szdiy/blackberry_q10_keyboard_pcb/Q10_keyboard.pdf

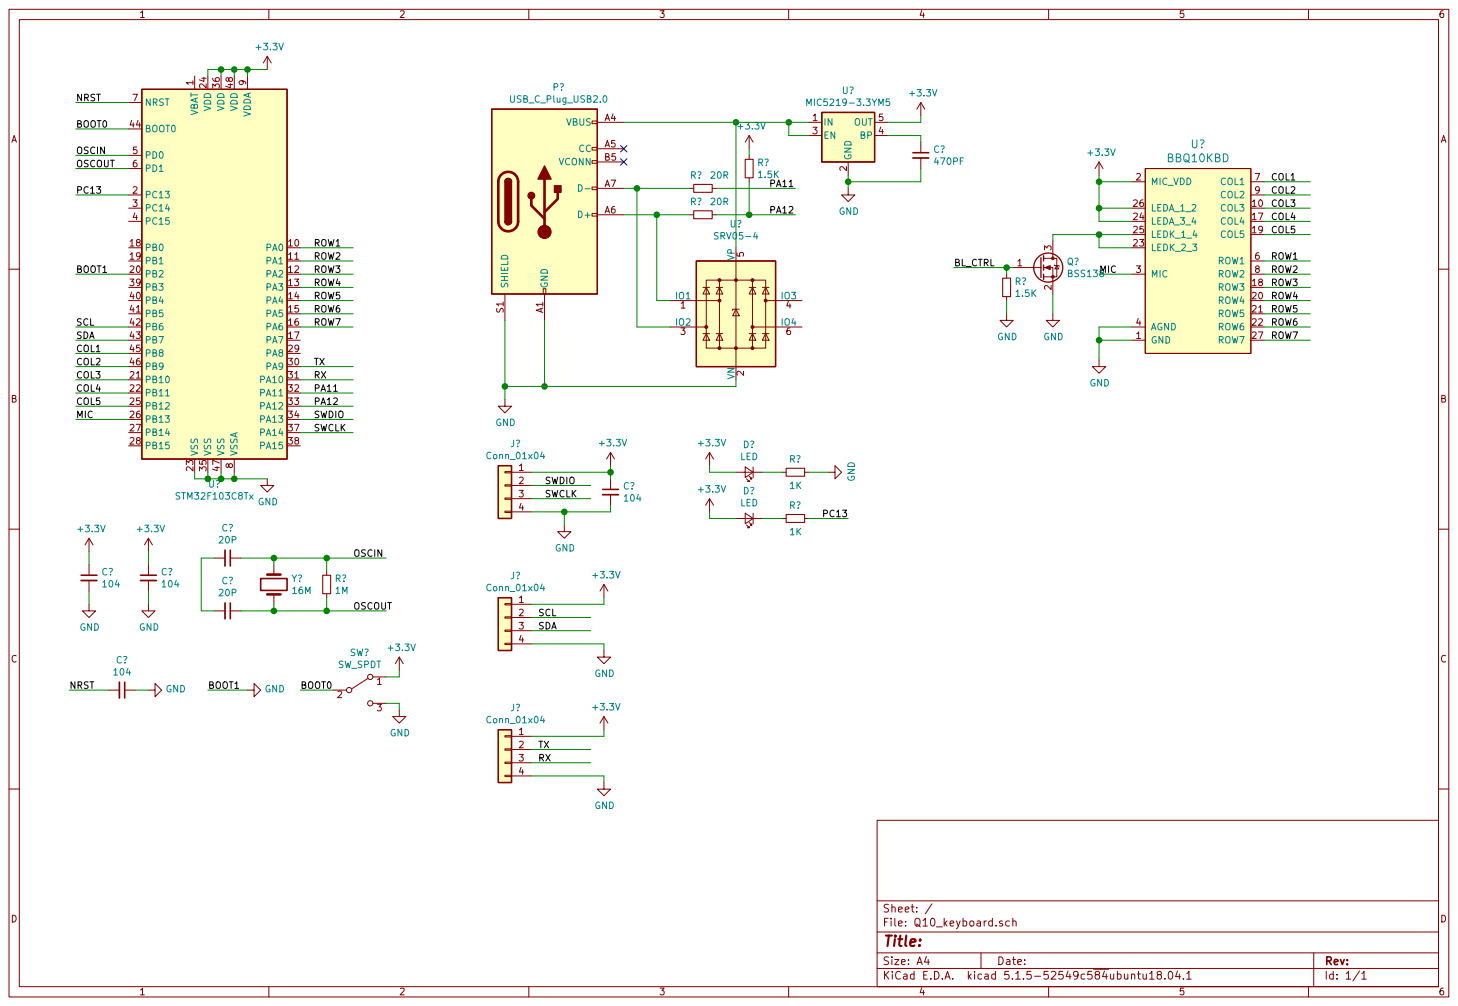
[picture p1: page 1]

1 VDD 24 VDD 36 VDD 48 VDDA

9 VSS 23 VSS 35 VSS 47 VSSA

File: Q10_keyboard.sch Sheet: / GND
