szdiy/blackberry_q10_keyboard_pcb/Q10_keyboard.kicad_pcb

## KiCad design Q10_keyboard.kicad_pcb (2020-10-12)

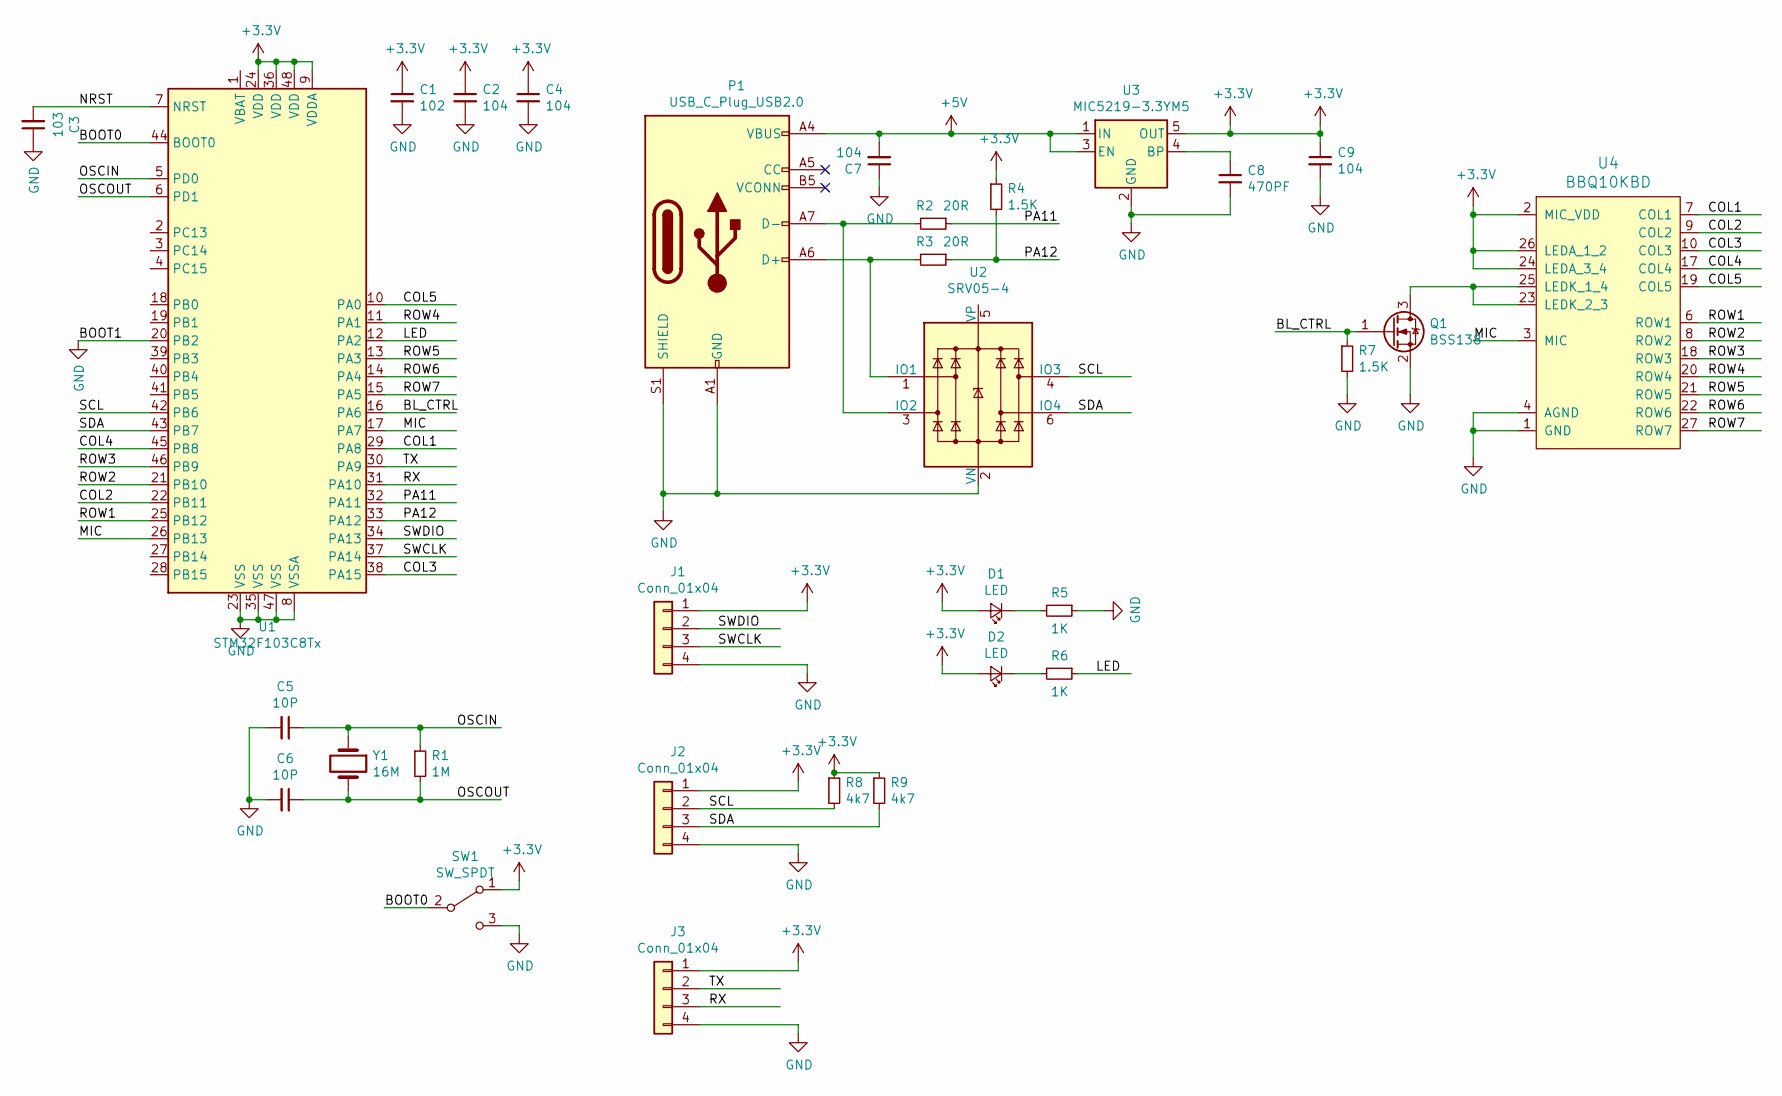
[picture p2: schematic Q10_keyboard.sch]

Parts:
C1: 102; C_0603_1608Metric_Pad1.05x0.95mm_HandSolder
C2, C4, C7, C9: 104; C_0603_1608Metric_Pad1.05x0.95mm_HandSolder
C3: 103; C_0603_1608Metric_Pad1.05x0.95mm_HandSolder
C5, C6: 10P; C_0603_1608Metric_Pad1.05x0.95mm_HandSolder
C8: 470PF; C_0603_1608Metric_Pad1.05x0.95mm_HandSolder
D1, D2: LED; LED_0603_1608Metric_Pad1.05x0.95mm_HandSolder
J1, J2, J3: Conn_01x04; PinHeader_1x04_P2.54mm_Vertical
P1: USB_C_Plug_USB2.0; USB_C_Receptacle_HRO_TYPE-C-31-M-12
Q1: BSS138; SOT-23
R1: 1M; R_0603_1608Metric_Pad1.05x0.95mm_HandSolder
R2, R3: 20R; R_0603_1608Metric_Pad1.05x0.95mm_HandSolder
R4, R7: 1.5K; R_0603_1608Metric_Pad1.05x0.95mm_HandSolder
R5, R6: 1K; R_0603_1608Metric_Pad1.05x0.95mm_HandSolder
R8, R9: 4k7; R_0603_1608Metric_Pad1.05x0.95mm_HandSolder
SW1: SW_SPDT; SW_SPDT_PCM12
U1: STM32F103C8Tx; LQFP-48_7x7mm_P0.5mm
U2: SRV05-4; SOT-23-6
U3: MIC5219-3.3YM5; SOT-23-5
U4: BBQ10KBD; BM14B(0.8)-24DS-0.4V(53)
Y1: 16M; Crystal_SMD_3225-4Pin_3.2x2.5mm_HandSoldering

Connections:
+3V3: C1.1, C2.1, C4.1, C9.1, D1.2 (A), D2.2 (A), J1.1, J2.1, J3.1, R4.1, R8.1, R9.1, SW1.1 (A), U1.9 (VDDA), U1.24 (VDD), U1.36 (VDD), U1.48 (VDD), U3.5 (OUT), U4.2 (MIC_VDD), U4.24 (LEDA_3_4), U4.26 (LEDA_1_2)
+5V: C7.2, P1.A4 (VBUS), P1.A9 (VBUS), P1.B4 (VBUS), P1.B9 (VBUS), U3.1 (IN), U3.3 (EN)
/BL_CTRL: Q1.1 (G), R7.1, U1.16 (PA6)
/BOOT0: SW1.2 (B), U1.44 (BOOT0)
/COL1: U1.29 (PA8), U4.7 (COL1)
/COL2: U1.22 (PB11), U4.9 (COL2)
/COL3: U1.38 (PA15), U4.10 (COL3)
/COL4: U1.45 (PB8), U4.17 (COL4)
/COL5: U1.10 (PA0), U4.19 (COL5)
/LED: R6.1, U1.12 (PA2)
/MIC: U1.17 (PA7), U1.26 (PB13), U4.3 (MIC)
/NRST: C3.2, U1.7 (NRST)
/OSCIN: C5.1, R1.1, U1.5 (PD0), Y1.1
/OSCOUT: C6.1, R1.2, U1.6 (PD1), Y1.2
/PA11: R2.1, U1.32 (PA11)
/PA12: R3.1, R4.2, U1.33 (PA12)
/ROW1: U1.25 (PB12), U4.6 (ROW1)
/ROW2: U1.21 (PB10), U4.8 (ROW2)
/ROW3: U1.46 (PB9), U4.18 (ROW3)
/ROW4: U1.11 (PA1), U4.20 (ROW4)
/ROW5: U1.13 (PA3), U4.21 (ROW5)
/ROW6: U1.14 (PA4), U4.22 (ROW6)
/ROW7: U1.15 (PA5), U4.27 (ROW7)
/RX: J3.3, U1.31 (PA10)
/SCL: J2.2, R8.2, U1.42 (PB6), U2.4 (IO3)
/SDA: J2.3, R9.2, U1.43 (PB7), U2.6 (IO4)
/SWCLK: J1.3, U1.37 (PA14)
/SWDIO: J1.2, U1.34 (PA13)
/TX: J3.2, U1.30 (PA9)
GND: C1.2, C2.2, C3.1, C4.2, C5.2, C6.2, C7.1, C8.2, C9.2, J1.4, J2.4, J3.4, P1.A1 (GND), P1.A12 (GND), P1.B1 (GND), P1.B12 (GND), P1.S1 (SHIELD), Q1.2 (S), R5.1, R7.2, SW1.3 (C), U1.8 (VSSA), U1.20 (PB2), U1.23 (VSS), U1.35 (VSS), U1.47 (VSS), U2.2 (VN), U3.2 (GND), U4.1 (GND), U4.4 (AGND), U4.5 (GND), U4.11 (GND), U4.12 (GND), U4.13 (GND), U4.14 (GND), U4.15 (GND), U4.16 (GND), U4.28 (GND)
unnamed: C8.1, U3.4 (BP)
unnamed: D1.1 (K), R5.2
unnamed: D2.1 (K), R6.2
unnamed: P1.A6 (D+), R3.2, U2.1 (IO1)
unnamed: P1.A7 (D-), R2.2, U2.3 (IO2)
unnamed: Q1.3 (D), U4.23 (LEDK_2_3), U4.25 (LEDK_1_4)

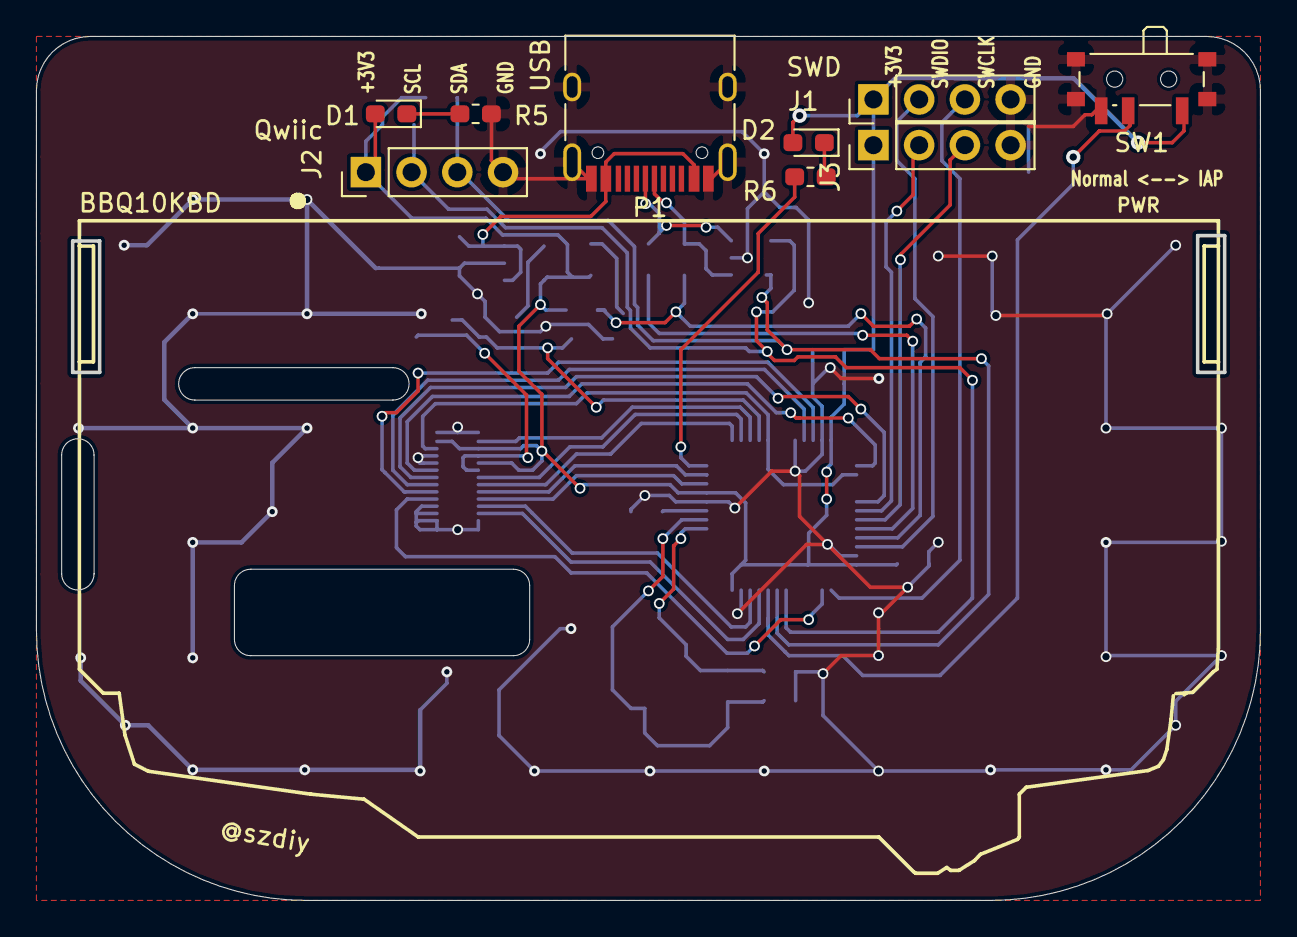
[picture p3: board Q10_keyboard.kicad_pcb from above]

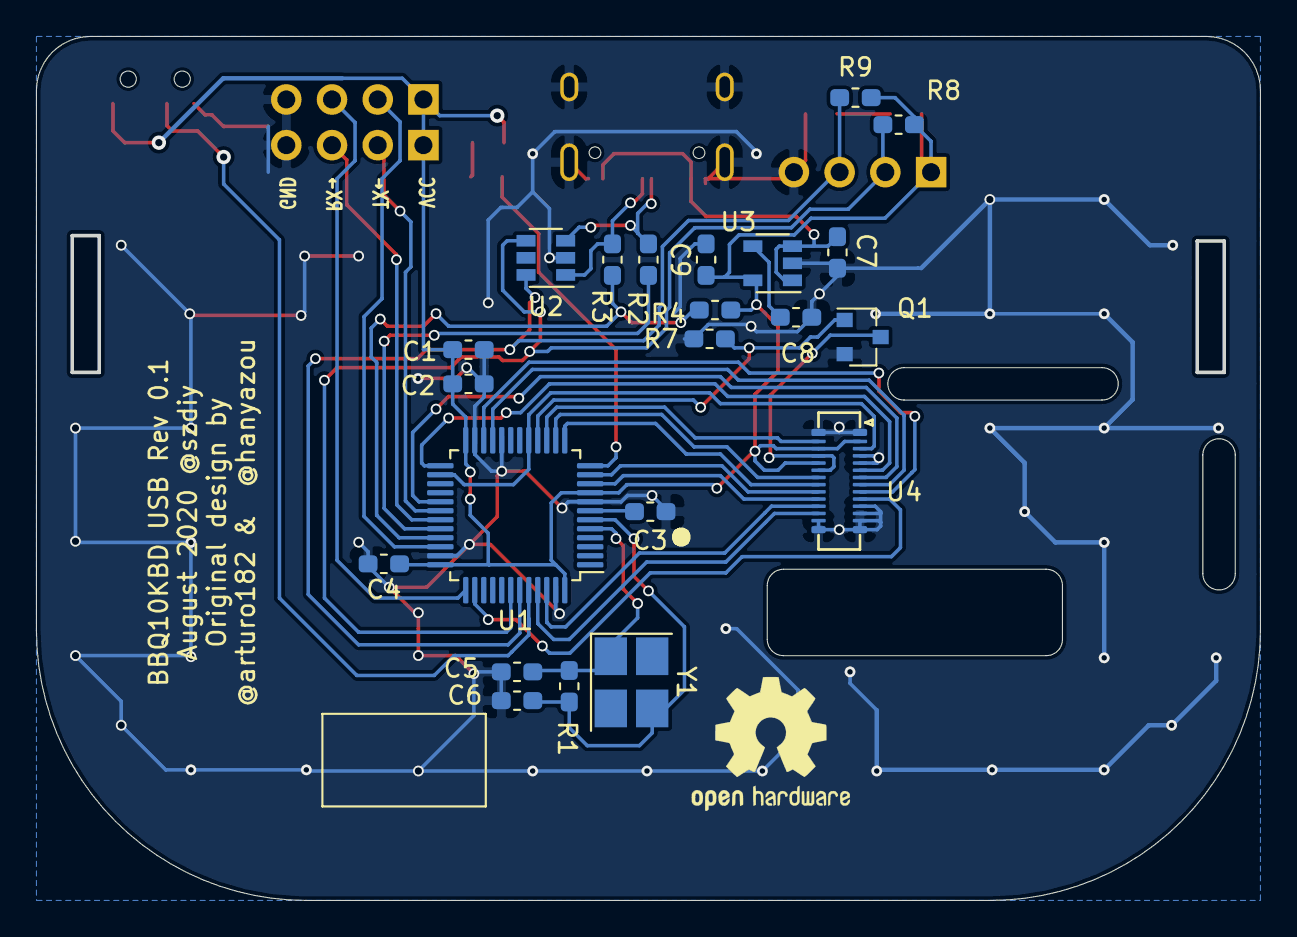
[picture p4: board Q10_keyboard.kicad_pcb from below]

Board: 2 copper layers, 68.0 x 48.0 mm, 31 parts (22 on the bottom side), 36 nets.
